Naps03/AeroGuard/esp32_Dev_Module/arduino-i2c-scd4x-master/arduino-i2c-scd4x-master/images/SCD41.png

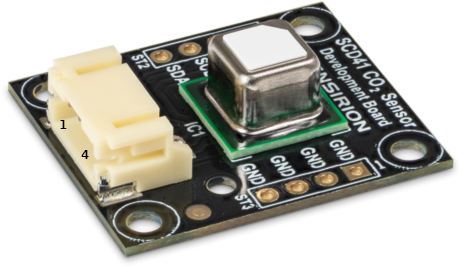
esp32_Dev_Module/arduino-i2c-scd4x-master/arduino-i2c-scd4x-master/images/SCD41.png
