Naps03/AeroGuard/esp32_Dev_Module/arduino-i2c-scd4x-master/arduino-i2c-scd4x-master/images/Arduino-Uno-Rev3-i2c-pinout-3.3V.png

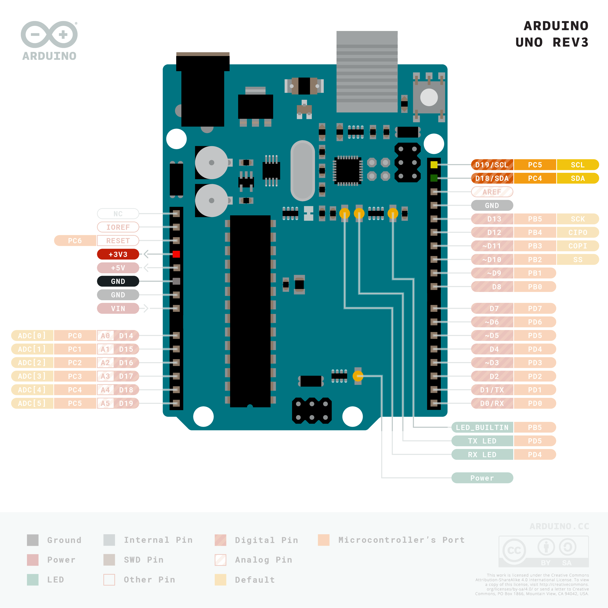
esp32_Dev_Module/arduino-i2c-scd4x-master/arduino-i2c-scd4x-master/images/Arduino-Uno-Rev3-i2c-pinout-3.3V.png
