Naps03/AeroGuard/(commit log)

2026-04-19 Strukturierung der SQLite-Datenbank
2026-04-19 Implementierung der CRUD Operationen fuer den Belegungsplan
2026-04-22 AÖgprithmus zur Logik der prädiktive Lüftungsvorhersage hinzugefügt
2026-04-28 Algorithmus zur Berechnung des IAQ-Scores
2026-05-06 Implementierung & Test der dynamischen Speicherung von Sensordaten und deren Visualisierung auf dem Dashboard
2026-05-20 ESP32 Dev Code
2026-06-03 ESP32 Dev Code mit Auslesen der Raumluftdaten & MQTT Einsatz
2026-06-09 update des python-backend zum Empafangen des SDC41 Sensordaten in Echzeit & Anzeige auf dem Dashboard
2026-06-12 Code zur Steuerung von LED & LD2410C hinzugefügt
2026-06-19 Updates on ESP32 Dev Module
2026-06-21 Updates auf der CO2-Wertebereiche
